Squeack/Rover/README.md

# Rover
6 wheel drive, 6 wheel steer rocker-bogie 'Mars rover'
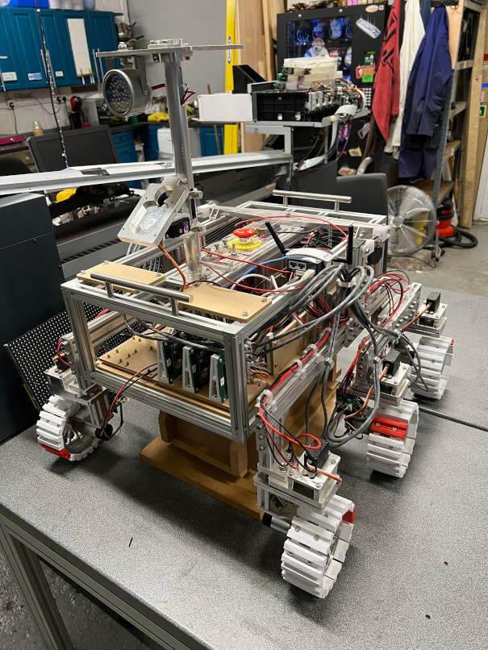
[picture p1: Images/chassis.jpg]
Chassis image
