Squeack/Rover/Head/Hardware/HeadAngles.xlsx

 | X | Y |  |  |  |  |  | X | Y
Center pivot | 0.00 | 0.00 |  | x1,y1 |  |  |  | 0.00 | 38.50
Servo pivot | 39.41 | 61.84 |  |  |  |  |  | 0.00 | 0.00
Separation |  |  | 73.33 |  |  |  |  | -17.47 | 34.31
Base link | 0.00 | 38.50 |  |  |  |  |  | 25.34 | 53.72
Distance |  |  | 38.50 | r1 |  |  |  | 39.41 | 61.84
Arm length |  |  | 16.25
Link length |  |  | 47.00 | r2
Angle | Arm X | Arm Y | Separation | dx | dy | a | px | py | h | Int X | Int Y | Head
60.00 | 25.34 | 53.72 | 59.39 | 0.43 | 0.90 | 23.58 | 10.06 | 21.32 | 30.44 | -17.47 | 34.31 | -26.98
80.00 | 23.41 | 59.02 | 63.49 | 0.37 | 0.93 | 26.02 | 9.59 | 24.19 | 28.37 | -16.78 | 34.65 | -25.84
75 | 23.71 | 57.63 | 62.32 | 0.38 | 0.92 | 25.33 | 9.64 | 23.43 | 28.99 | -17.17 | 34.46 | -26.49
70.00 | 24.14 | 56.28 | 61.24 | 0.39 | 0.92 | 24.69 | 9.73 | 22.69 | 29.54 | -17.42 | 34.33 | -26.90
65.00 | 24.68 | 54.97 | 60.26 | 0.41 | 0.91 | 24.10 | 9.87 | 21.99 | 30.02 | -17.52 | 34.28 | -27.07
60 | 25.34 | 53.72 | 59.39 | 0.43 | 0.90 | 23.58 | 10.06 | 21.32 | 30.44 | -17.47 | 34.31 | -26.98
55.00 | 26.10 | 52.52 | 58.65 | 0.45 | 0.90 | 23.13 | 10.29 | 20.71 | 30.78 | -17.27 | 34.41 | -26.65
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
