Squeack/Rover/Electronics/Communication.png

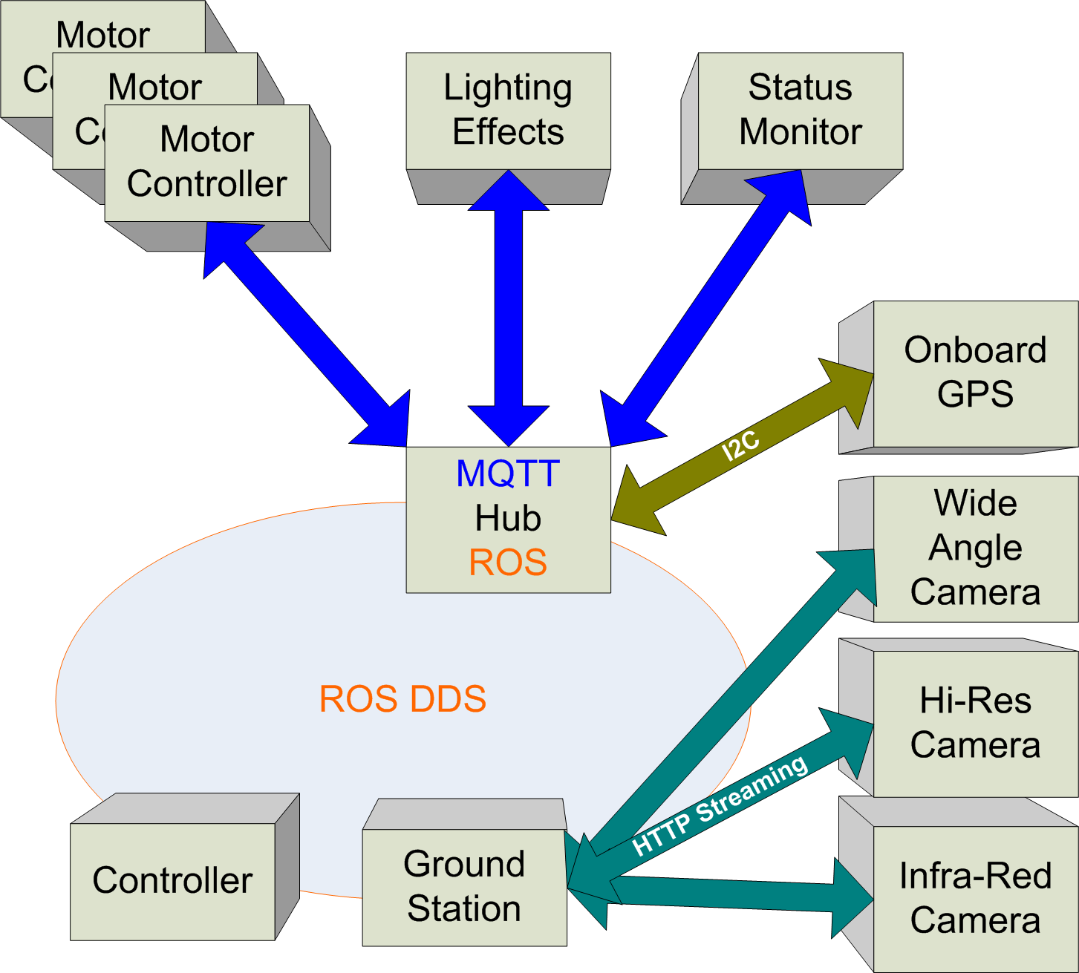
Electronics/Communication.png
