Squeack/Rover/Electronics/MarsRoverPower.jpg

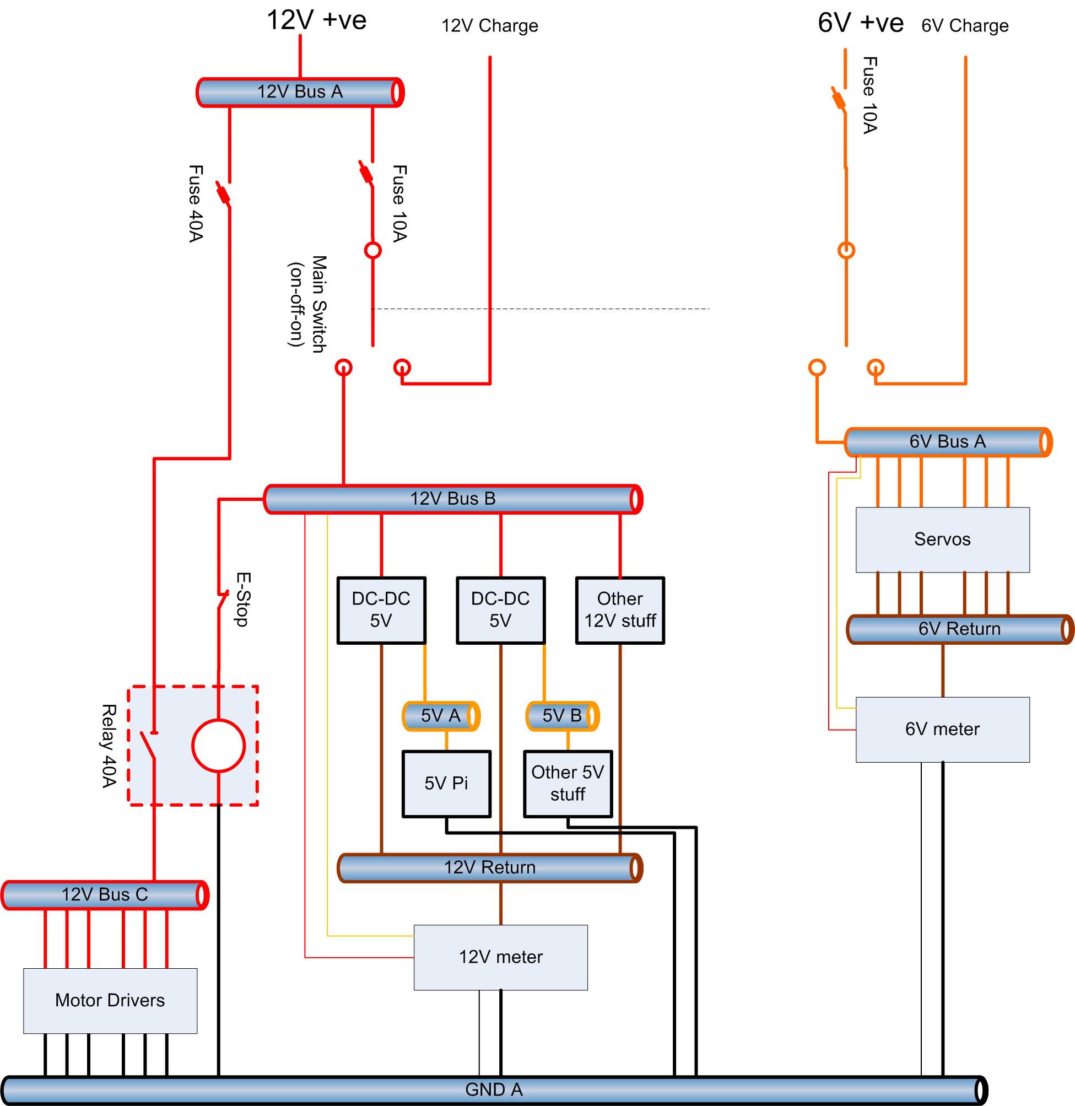
Electronics/MarsRoverPower.jpg
