Squeack/Rover/Electronics/WheelConnector/WheelConnectionsBack.png

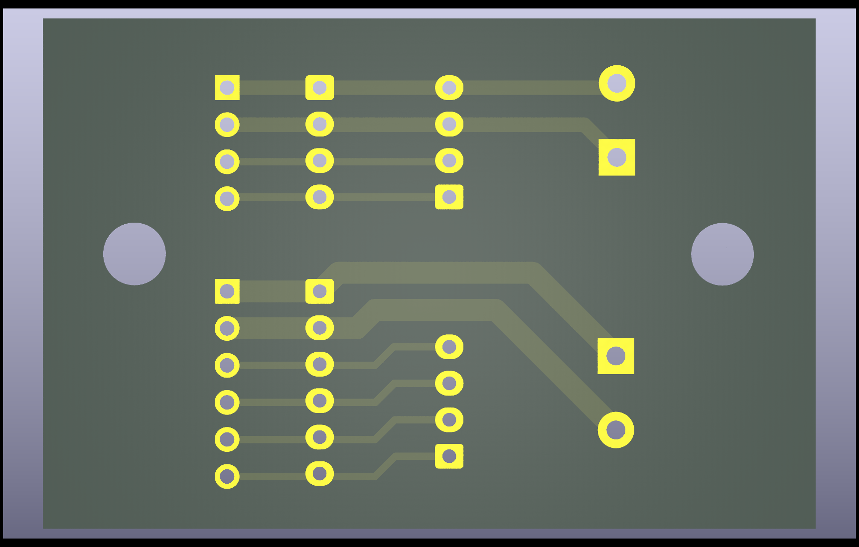
Electronics/WheelConnector/WheelConnectionsBack.png
