Squeack/Rover/Electronics/WheelConnector/WheelConnectionsBack_flipped.png

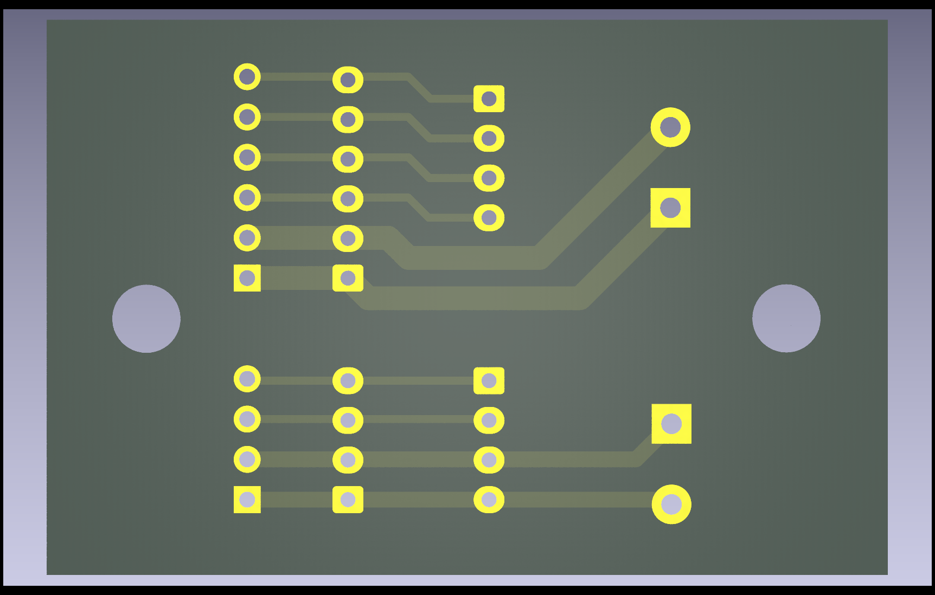
Electronics/WheelConnector/WheelConnectionsBack_flipped.png
