Squeack/Rover/Electronics/WheelConnector/WheelConnectionsFront.png

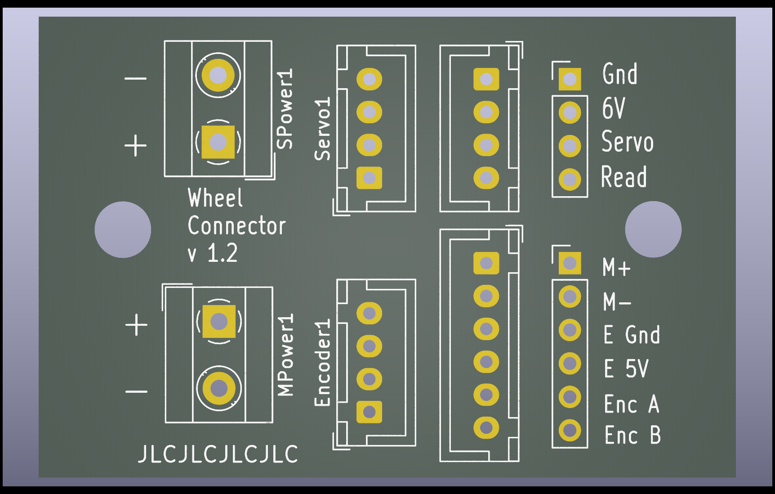
Electronics/WheelConnector/WheelConnectionsFront.png
