Squeack/Rover/Electronics/WheelConnector/WheelConnectionsFront_flipped.png

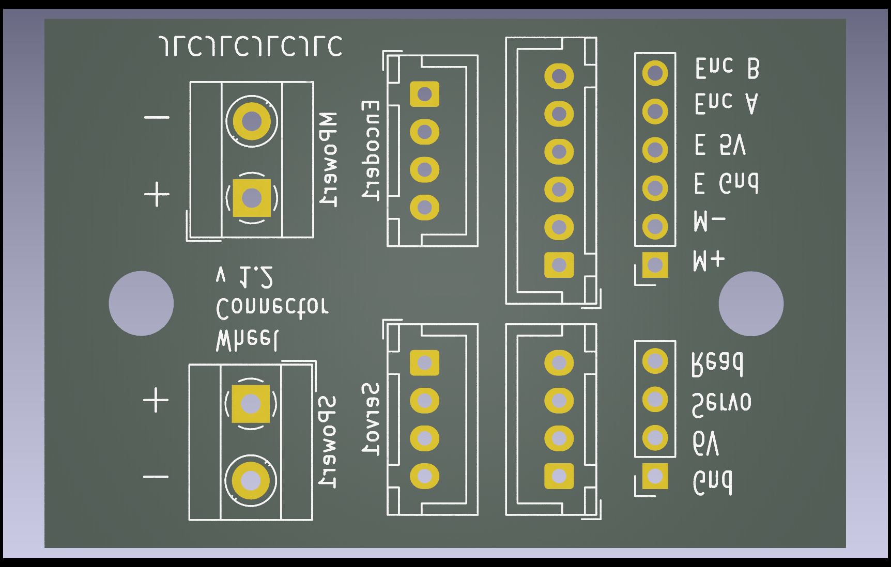
Electronics/WheelConnector/WheelConnectionsFront_flipped.png
