Squeack/Rover/Electronics/WheelController/Back.png

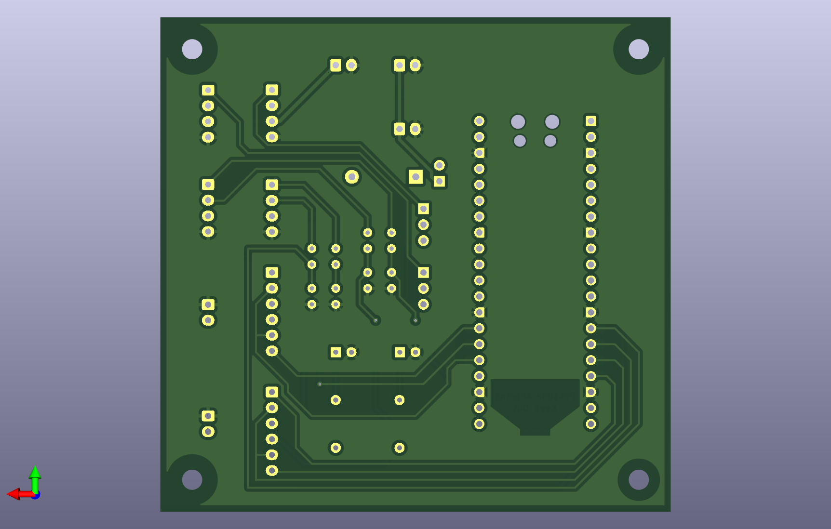
Electronics/WheelController/Back.png
