Squeack/Rover/Electronics/WheelController/Front.png

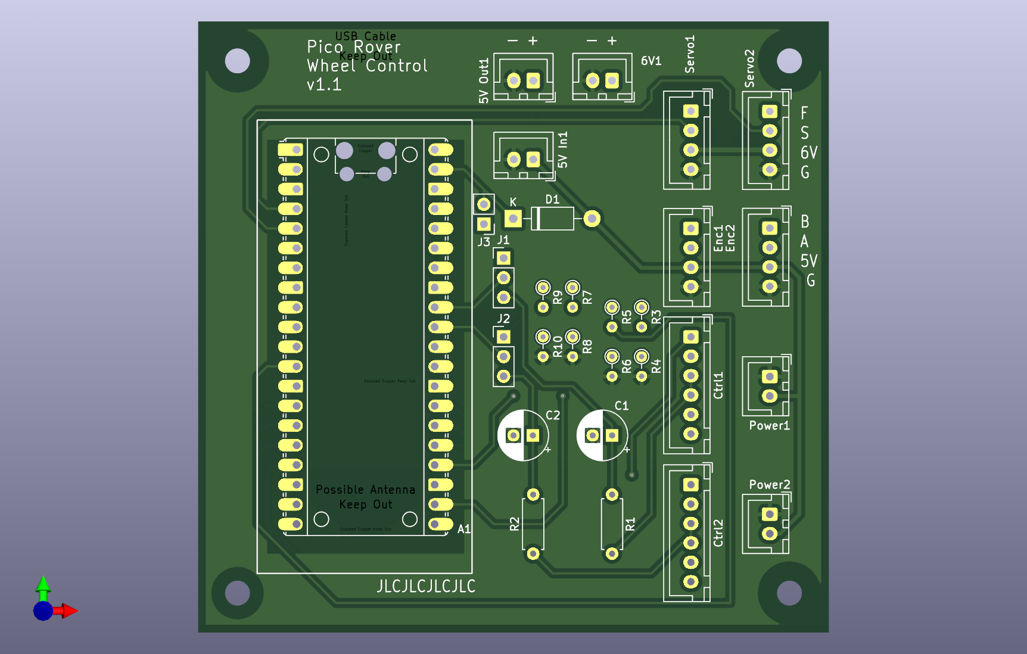
Electronics/WheelController/Front.png
