Squeack/Rover/Electronics/WheelController/schematic_v110.png

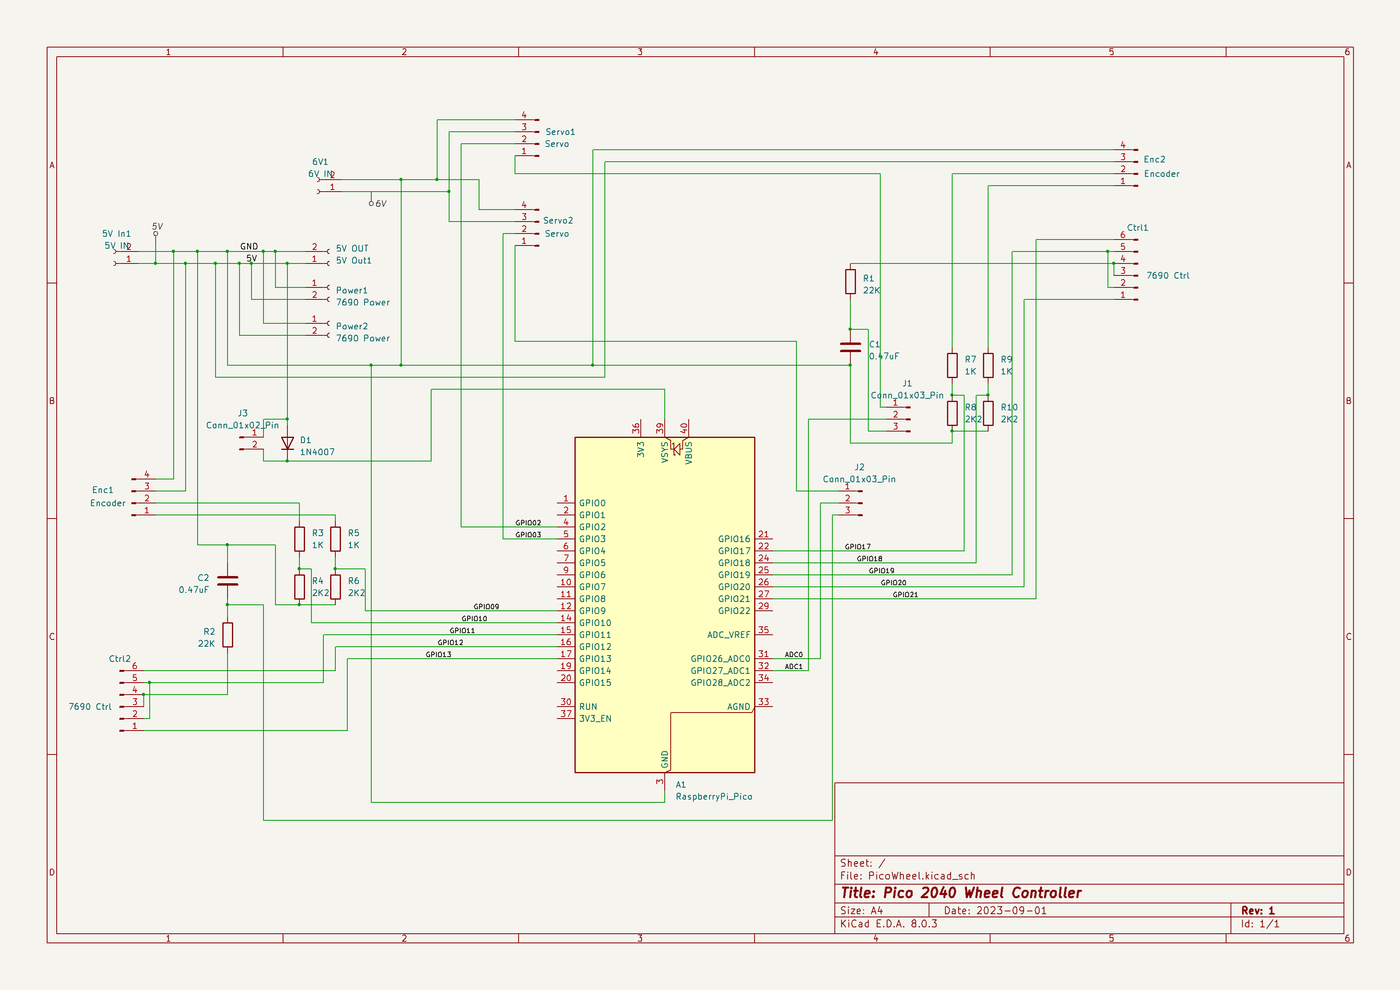
Electronics/WheelController/schematic_v110.png
