Squeack/Rover/Images/controller.jpg

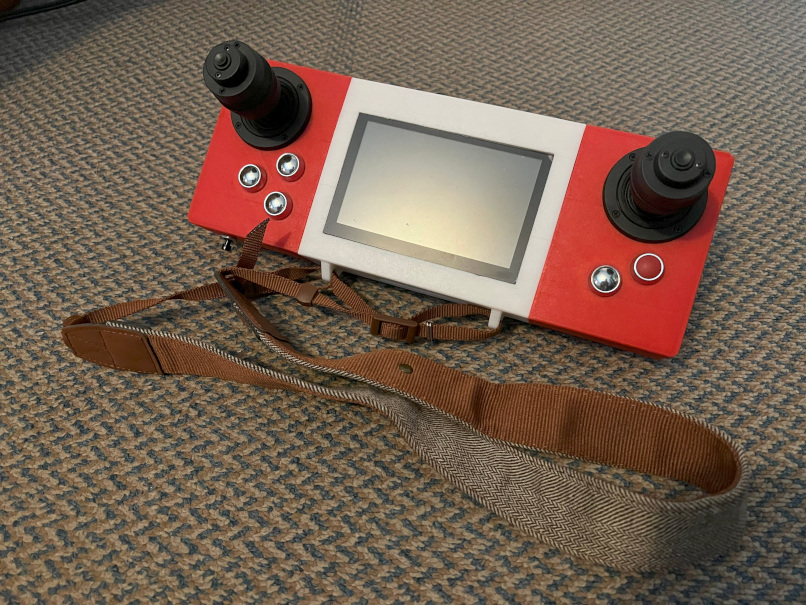
Images/controller.jpg
