Squeack/Rover/Images/head.jpg

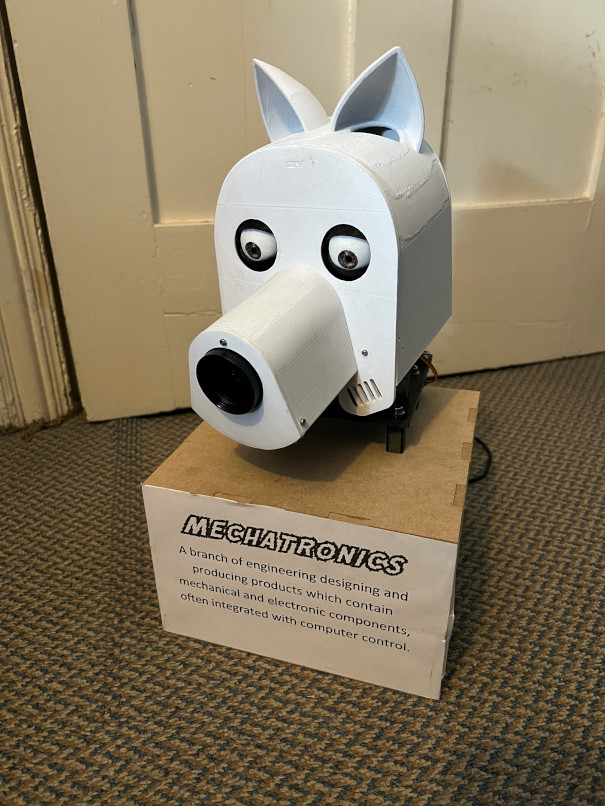
Images/head.jpg
