Squeack/Rover/Controller/Main Case v16.stl

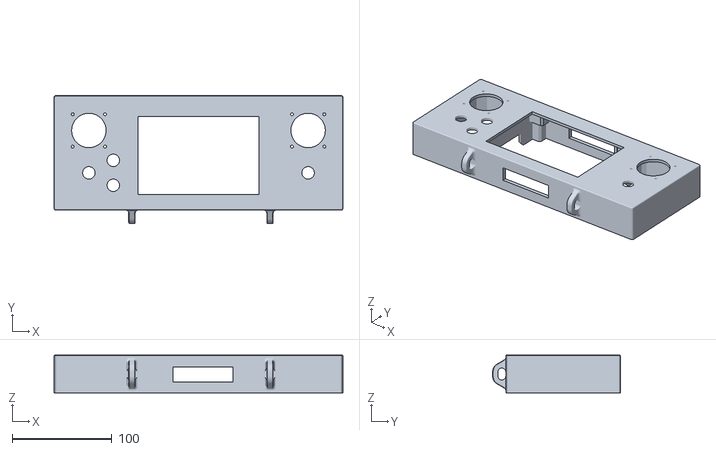
[picture p13: CAD file, 2026-04-24]
Controller/Main Case v16.stl
290.0 x 128.3 x 38.0
