Squeack/Rover/Controller/Screen Mount Single-Ended v1.stl

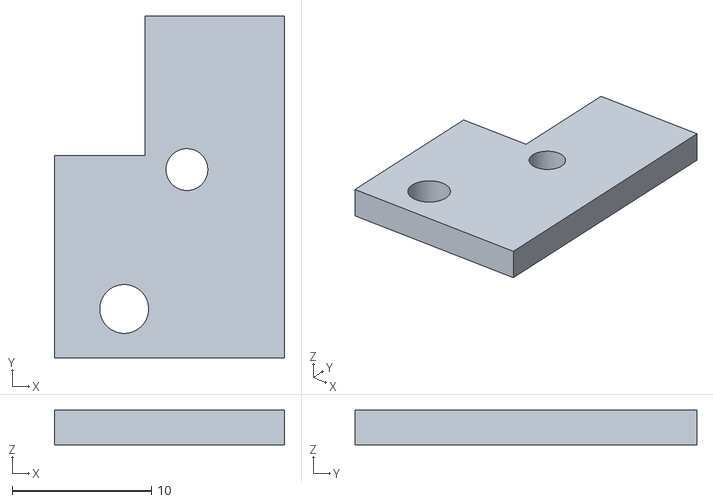
[picture p14: CAD file, 2026-04-24]
Controller/Screen Mount Single-Ended v1.stl
16.5 x 24.5 x 2.50
