Squeack/Rover/Electronics/WheelConnector/WheelConnections.step

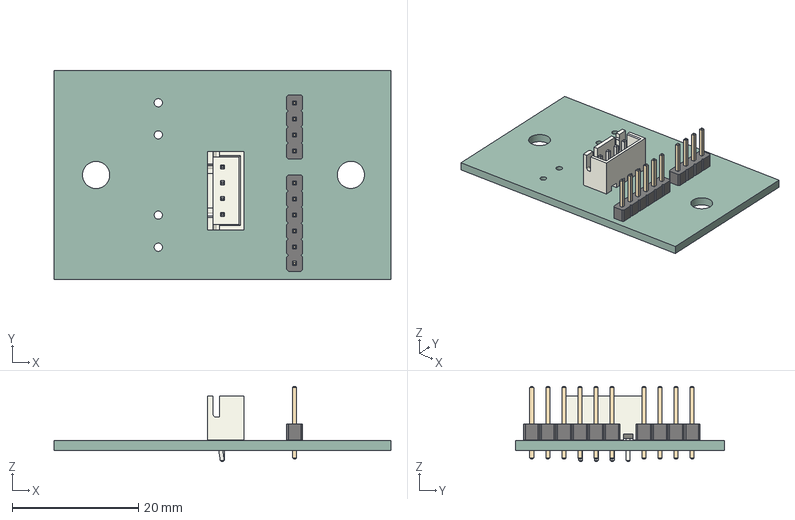
[picture p15: CAD file, 2026-04-24]
Electronics/WheelConnector/WheelConnections.step
53.3 x 33.0 x 11.9 mm
PinHeader_1x06_P254mm_Vertical
PinHeader_1x04_P254mm_Vertical
JST_B4B_XH_A
WheelConnections_PCB
