Squeack/Rover/Electronics/WheelController/PicoWheel.step

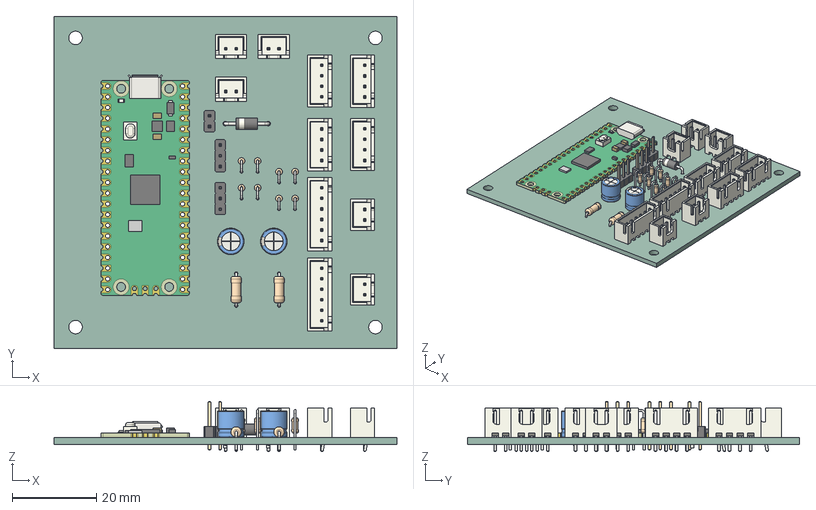
[picture p16: CAD file, 2026-04-24]
Electronics/WheelController/PicoWheel.step
81.3 x 78.7 x 11.9 mm
R_Axial_DIN0204_L36mm_D16mm_P254mm_Vertical x 8
JST_B2B_XH_A x 5
JST_B6B_XH_A x 2
PinHeader_1x03_P254mm_Vertical x 2
PinHeader_1x02_P254mm_Vertical
CP_Radial_D63mm_P250mm x 2
R_Axial_DIN0207_L63mm_D25mm_P762mm_Horizontal x 2
JST_B4B_XH_A x 4
D_DO-41_SOD81_P10.16mm_Horizontal
RaspberryPi_Pico_Compound
PicoWheel_PCB
