Squeack/Rover/Controller/Screen Mount v2.stl

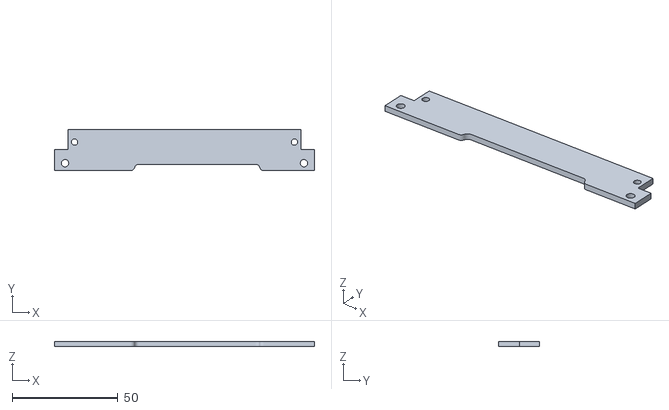
[picture p17: CAD file, 2026-04-24]
Controller/Screen Mount v2.stl
123.0 x 19.5 x 2.50
