Squeack/Rover/Controller/Nano Clamp v1.stl

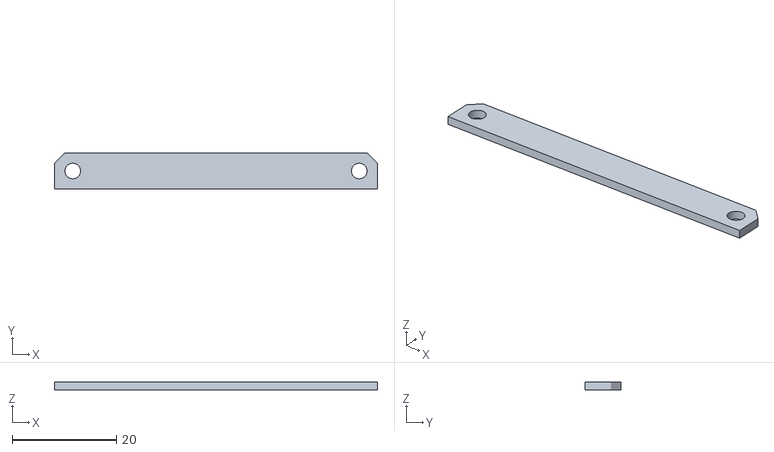
[picture p18: CAD file, 2026-04-24]
Controller/Nano Clamp v1.stl
62.0 x 7.00 x 1.50
