Squeack/Rover/Controller/Case Lid v8.stl

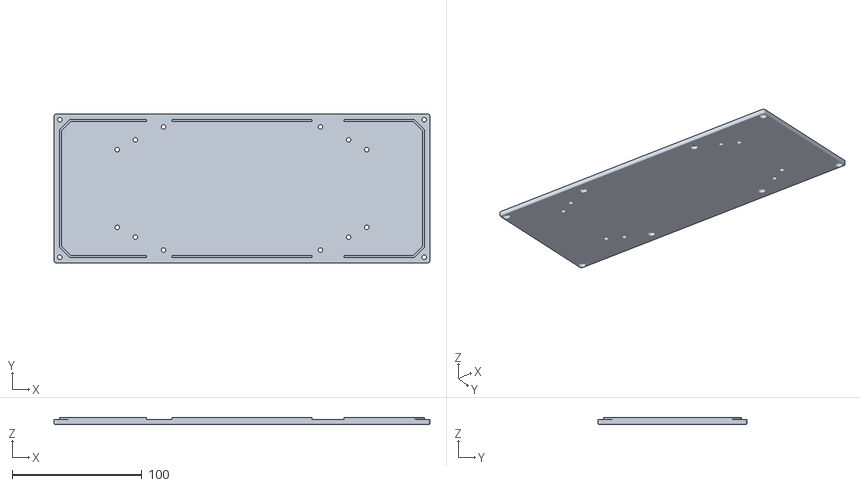
[picture p19: CAD file, 2026-04-24]
Controller/Case Lid v8.stl
290.0 x 115.0 x 5.50
