Squeack/Rover/Controller/Stand v1.stl

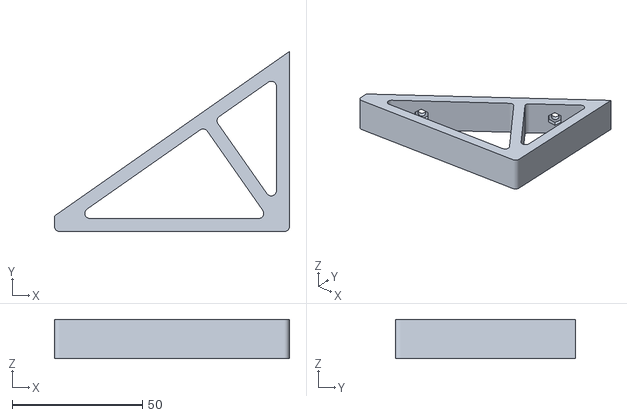
[picture p20: CAD file, 2026-04-24]
Controller/Stand v1.stl
90.1 x 69.1 x 15.0
