Squeack/Rover/Controller/Battery clip v1.stl

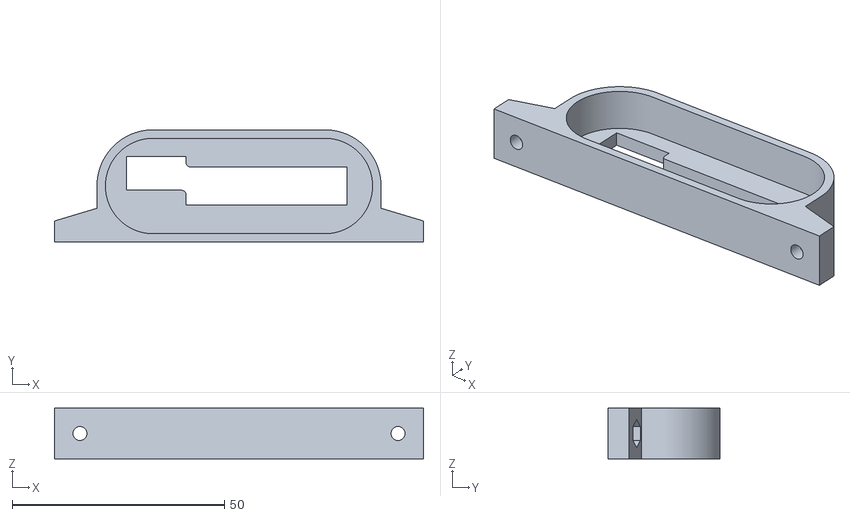
[picture p21: CAD file, 2026-04-24]
Controller/Battery clip v1.stl
87.0 x 26.5 x 12.0
