Squeack/Rover/Electronics/WheelConnector/WheelConnections.kicad_pcb

## KiCad design Electronics/WheelConnector/WheelConnections.kicad_pcb (2026-04-24)

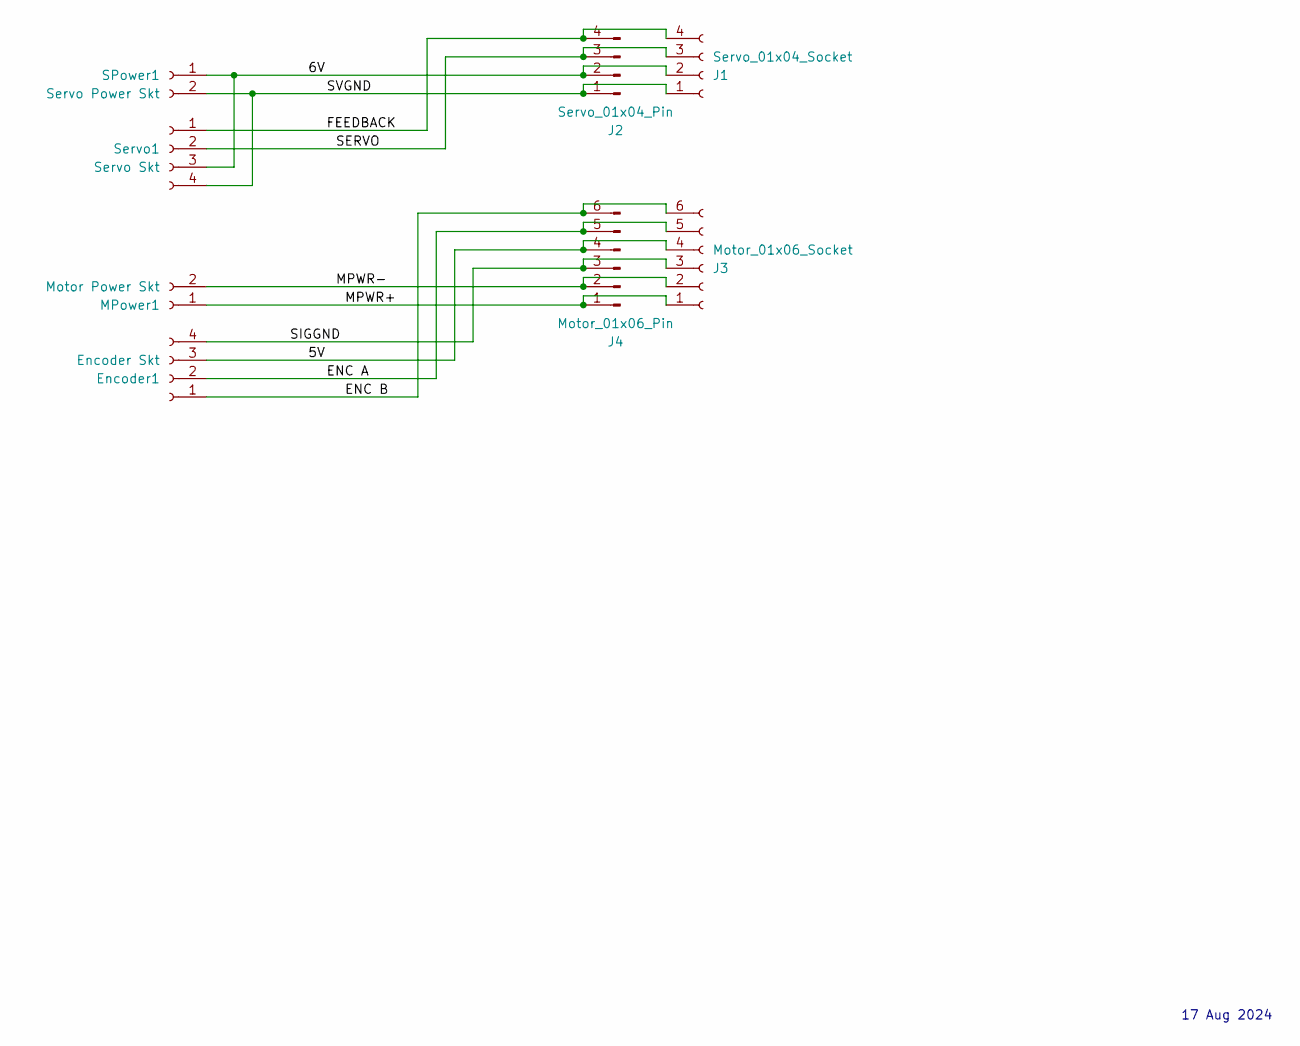
[picture p22: schematic WheelConnections.kicad_sch]

Parts:
Encoder1: Encoder Skt; JST_XH_B4B-XH-A_1x04_P2.50mm_Vertical
J1: Servo_01x04_Socket; JST_XH_B4B-XH-A_1x04_P2.50mm_Vertical
J2: Servo_01x04_Pin; PinHeader_1x04_P2.54mm_Vertical
J3: Motor_01x06_Socket; JST_XH_B6B-XH-A_1x06_P2.50mm_Vertical
J4: Motor_01x06_Pin; PinHeader_1x06_P2.54mm_Vertical
MPower1: Motor Power Skt; TerminalBlock_MetzConnect_Type101_RT01602HBWC_1x02_P5.08mm_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
SPower1: Servo Power Skt; TerminalBlock_MetzConnect_Type101_RT01602HBWC_1x02_P5.08mm_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
Servo1: Servo Skt; JST_XH_B4B-XH-A_1x04_P2.50mm_Vertical

Connections:
/5V: Encoder1.3, J3.4, J4.4
/6V: J1.2, J2.2, SPower1.1, Servo1.3
/ENC A: Encoder1.2, J3.5, J4.5
/ENC B: Encoder1.1, J3.6, J4.6
/FEEDBACK: J1.4, J2.4, Servo1.1
/MPWR+: J3.1, J4.1, MPower1.1
/MPWR-: J3.2, J4.2, MPower1.2
/SERVO: J1.3, J2.3, Servo1.2
/SIGGND: Encoder1.4, J3.3, J4.3
/SVGND: J1.1, J2.1, SPower1.2, Servo1.4

Notes on the sheet:
17 Aug 2024

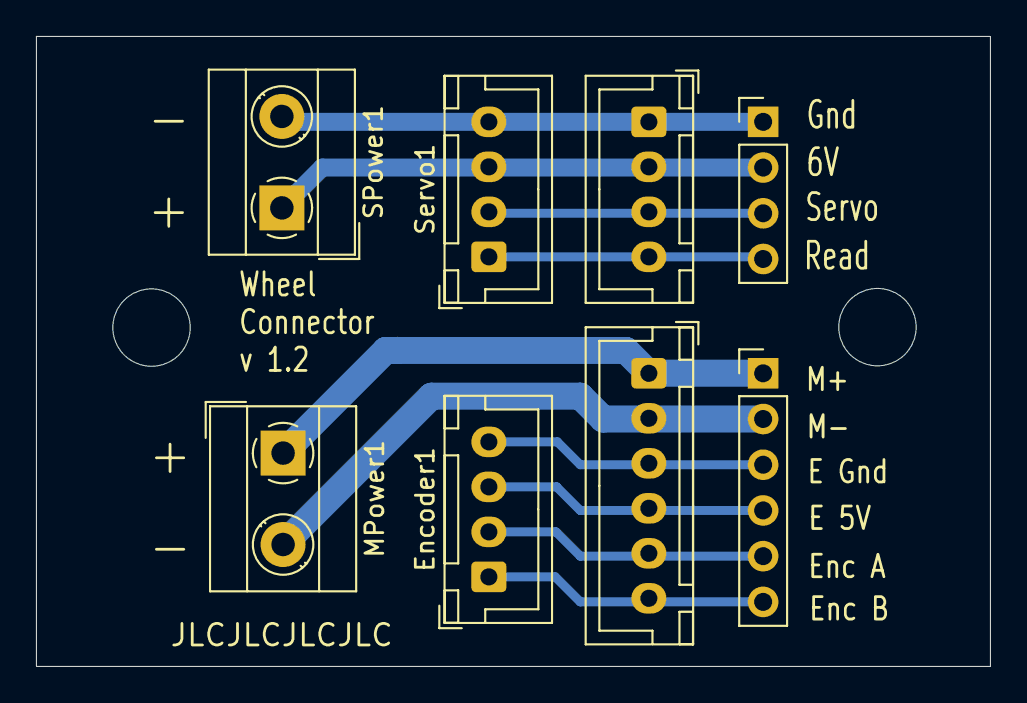
[picture p23: board WheelConnections.kicad_pcb from above]

Board: 2 copper layers, 53.0 x 35.0 mm, 8 parts (0 on the bottom side), 10 nets.
