Squeack/Rover/Electronics/WheelController/PicoWheel.kicad_pcb

## KiCad design Electronics/WheelController/PicoWheel.kicad_pcb (2026-04-24)

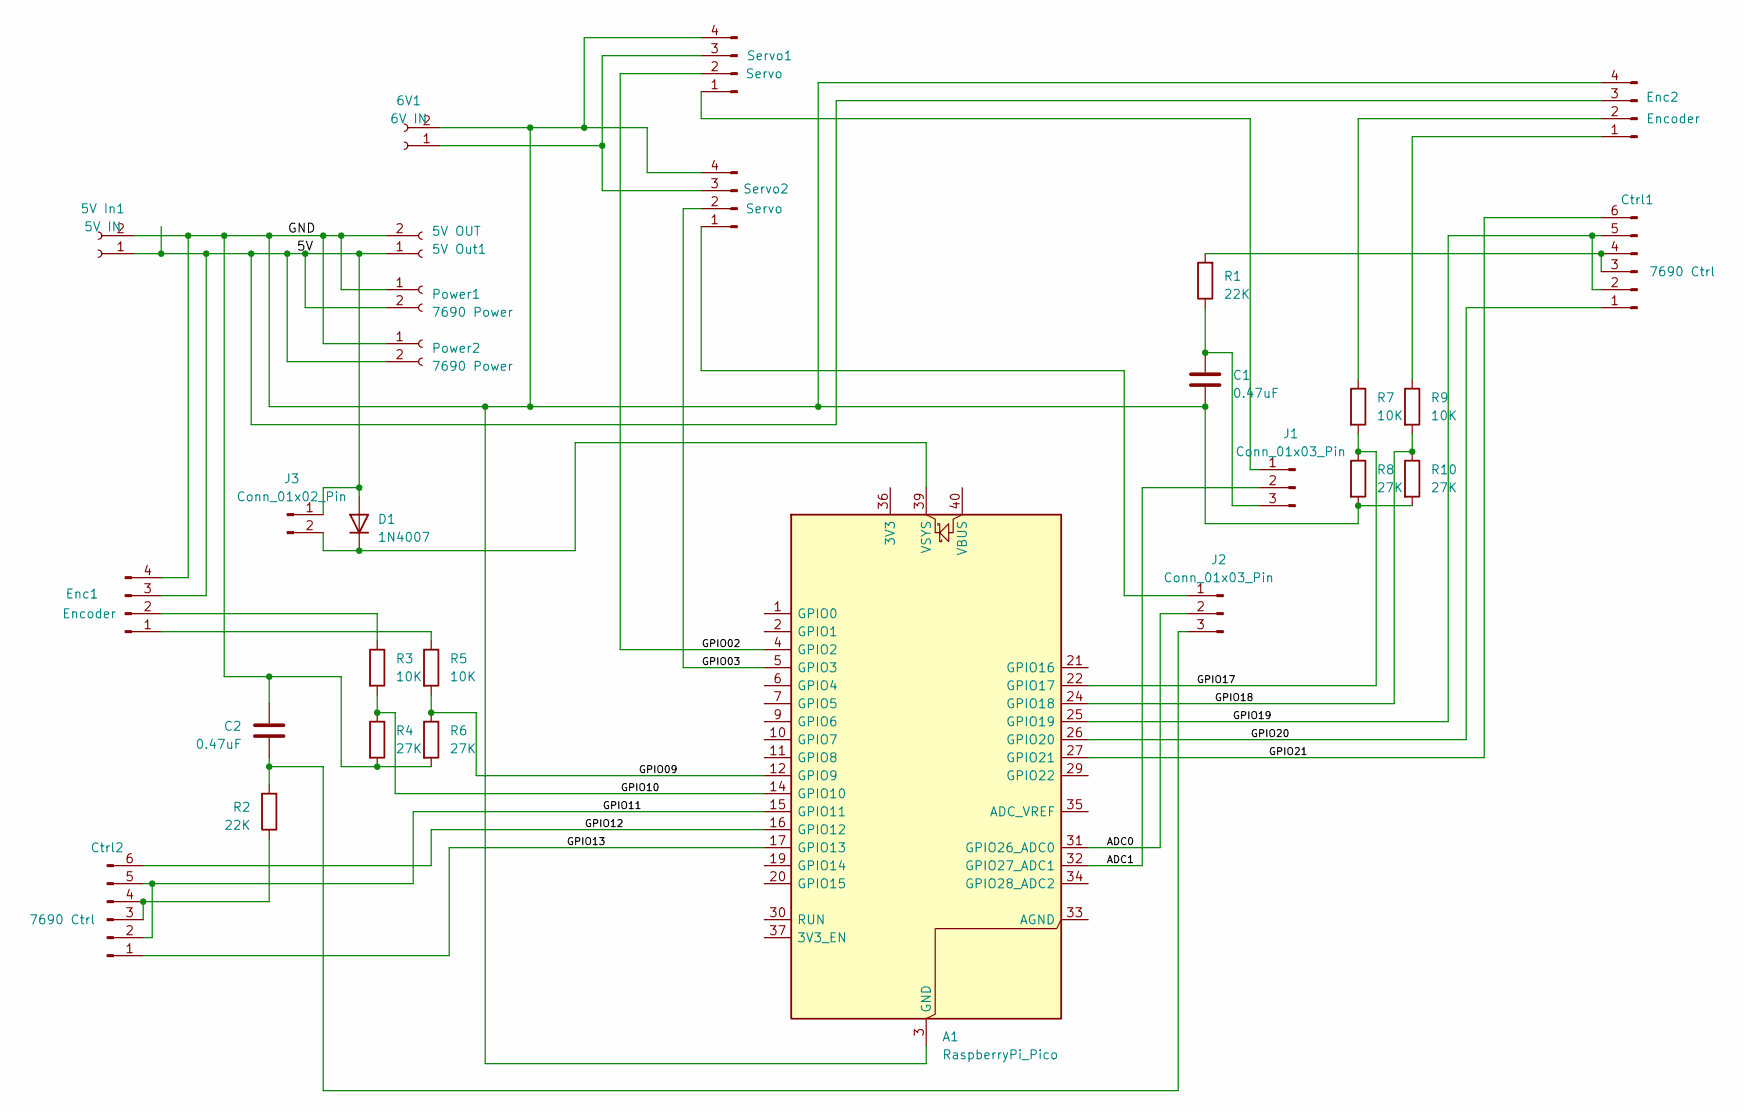
[picture p24: schematic PicoWheel.kicad_sch, Pico 2040 Wheel Controller]

Parts:
5V In1: 5V IN; JST_XH_B2B-XH-A_1x02_P2.50mm_Vertical
5V Out1: 5V OUT; JST_XH_B2B-XH-A_1x02_P2.50mm_Vertical
6V1: 6V IN; JST_XH_B2B-XH-A_1x02_P2.50mm_Vertical
A1: RaspberryPi_Pico; RaspberryPi_Pico_Common
C1, C2: 0.47uF; CP_Radial_D6.3mm_P2.50mm
Ctrl1, Ctrl2: 7690 Ctrl; JST_XH_B6B-XH-A_1x06_P2.50mm_Vertical
D1: 1N4007; D_DO-41_SOD81_P10.16mm_Horizontal
Enc1, Enc2: Encoder; JST_XH_B4B-XH-A_1x04_P2.50mm_Vertical
J1, J2: Conn_01x03_Pin; PinHeader_1x03_P2.54mm_Vertical
J3: Conn_01x02_Pin; PinHeader_1x02_P2.54mm_Vertical
Power1, Power2: 7690 Power; JST_XH_B2B-XH-A_1x02_P2.50mm_Vertical
R1, R2: 22K; R_Axial_DIN0207_L6.3mm_D2.5mm_P7.62mm_Horizontal
R3, R5, R7, R9: 10K; R_Axial_DIN0204_L3.6mm_D1.6mm_P2.54mm_Vertical
R4, R6, R8, R10: 27K; R_Axial_DIN0204_L3.6mm_D1.6mm_P2.54mm_Vertical
Servo1, Servo2: Servo; JST_XH_B4B-XH-A_1x04_P2.50mm_Vertical

Connections:
/5V: 5V In1.1, 5V Out1.1, D1.2 (A), Enc1.3, Enc2.3, J3.1, Power1.2, Power2.2
/ADC0: A1.31 (GPIO26_ADC0), J2.2
/ADC1: A1.32 (GPIO27_ADC1), J1.2
/GND: 5V In1.2, 5V Out1.2, 6V1.2, A1.3 (GND), A1.8 (GND), A1.13 (GND), A1.18 (GND), A1.23 (GND), A1.28 (GND), A1.38 (GND), C1.2, C2.2, Enc1.4, Enc2.4, Power1.1, Power2.1, R4.2, R6.2, R8.2, R10.2, Servo1.4, Servo2.4
/GPIO02: A1.4 (GPIO2), Servo1.2
/GPIO03: A1.5 (GPIO3), Servo2.2
/GPIO09: A1.12 (GPIO9), R5.2, R6.1
/GPIO10: A1.14 (GPIO10), R3.2, R4.1
/GPIO11: A1.15 (GPIO11), Ctrl2.2, Ctrl2.5
/GPIO12: A1.16 (GPIO12), Ctrl2.6
/GPIO13: A1.17 (GPIO13), Ctrl2.1
/GPIO17: A1.22 (GPIO17), R7.2, R8.1
/GPIO18: A1.24 (GPIO18), R9.2, R10.1
/GPIO19: A1.25 (GPIO19), Ctrl1.2, Ctrl1.5
/GPIO20: A1.26 (GPIO20), Ctrl1.1
/GPIO21: A1.27 (GPIO21), Ctrl1.6
unnamed: 6V1.1, Servo1.3, Servo2.3
unnamed: A1.39 (VSYS), D1.1 (K), J3.2
unnamed: Ctrl1.3, Ctrl1.4, R1.2
unnamed: Ctrl2.3, Ctrl2.4, R2.1
unnamed: Enc1.1, R5.1
unnamed: Enc1.2, R3.1
unnamed: Enc2.1, R9.1
unnamed: Enc2.2, R7.1
unnamed: J1.1, Servo1.1
unnamed: C1.1, J1.3, R1.1
unnamed: J2.1, Servo2.1
unnamed: C2.1, J2.3, R2.2

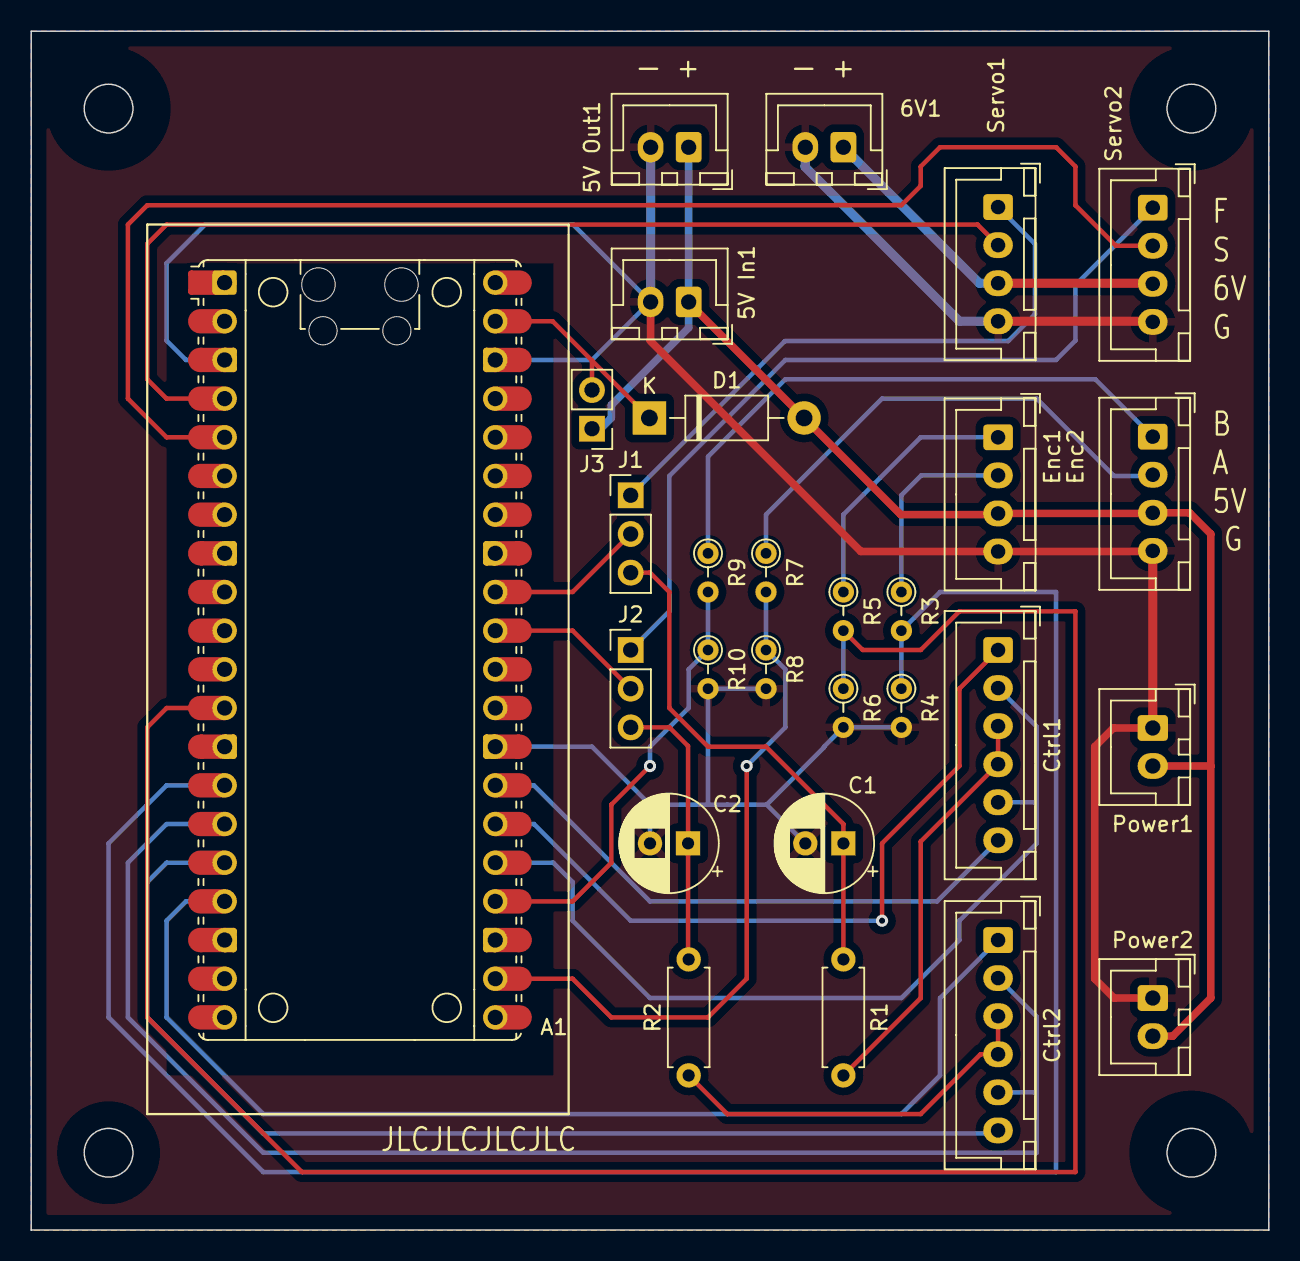
[picture p25: board PicoWheel.kicad_pcb from above]

Board: 2 copper layers, 81.3 x 78.7 mm, 28 parts (0 on the bottom side), 28 nets.
